kminek22/rc-car/cad/stl/rc car.stl

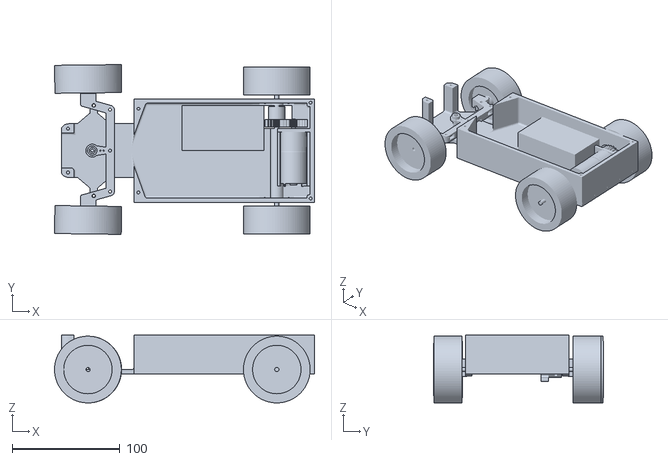
[picture p1: CAD file, 2026-11-02]
cad/stl/rc car.stl
241.5 x 157.8 x 63.0
