kminek22/rc-car/cad/stl/koło.stl

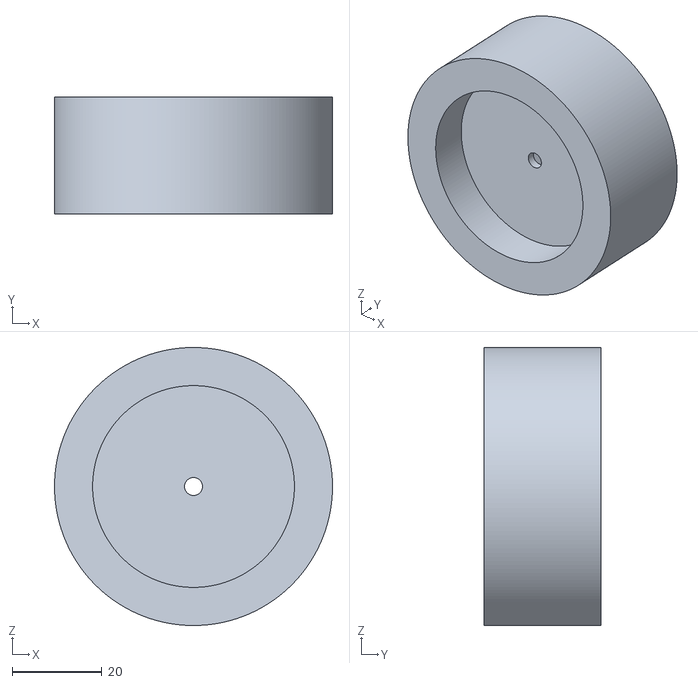
[picture p2: CAD file, 2026-11-02]
cad/stl/koło.stl
62.0 x 26.0 x 62.0
