kminek22/rc-car/cad/stl/zebatka1.stl

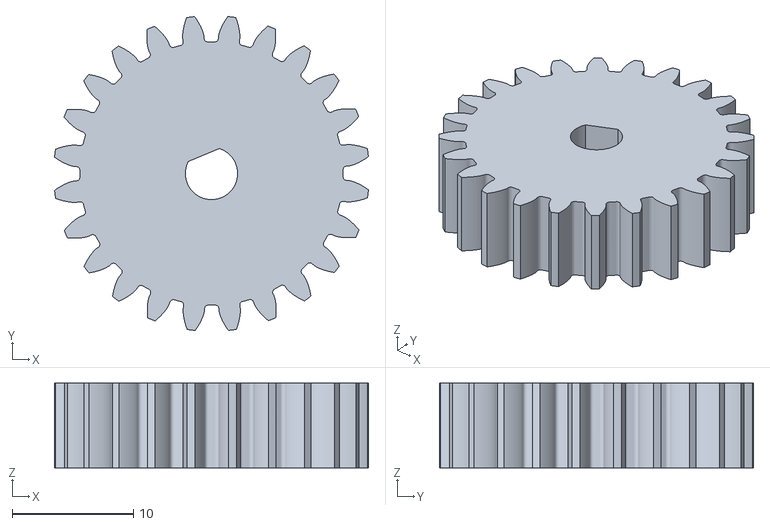
[picture p3: CAD file, 2026-11-02]
cad/stl/zebatka1.stl
25.9 x 25.9 x 7.00
