kminek22/rc-car/cad/stl/adapter.stl

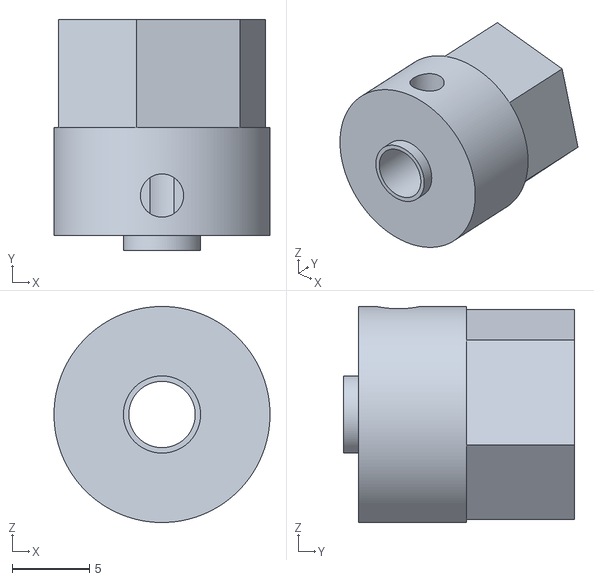
[picture p4: CAD file, 2026-11-02]
cad/stl/adapter.stl
14.0 x 15.0 x 14.0
