kminek22/rc-car/cad/stl/podwozie.stl

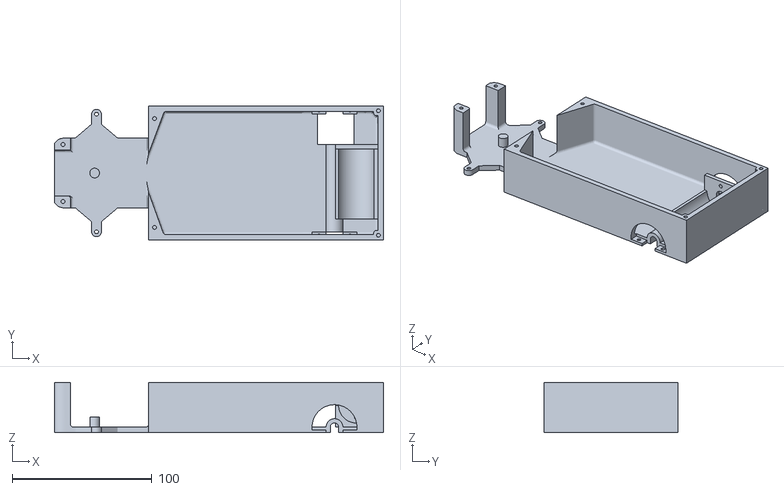
[picture p5: CAD file, 2026-11-02]
cad/stl/podwozie.stl
235.0 x 96.0 x 36.0
