kminek22/rc-car/cad/stl/zacisk.stl

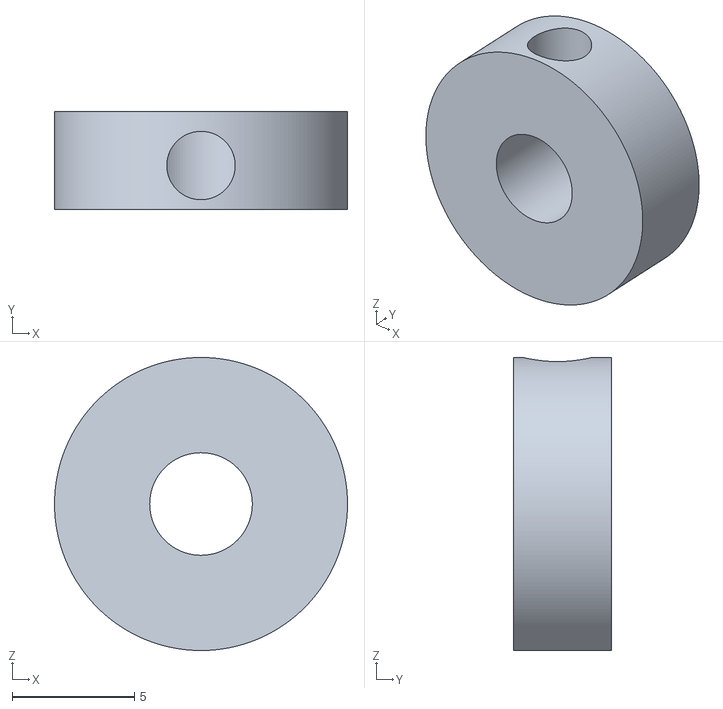
[picture p6: CAD file, 2026-11-02]
cad/stl/zacisk.stl
12.0 x 4.00 x 12.0
