kminek22/rc-car/cad/stl/drazek_acermann.stl

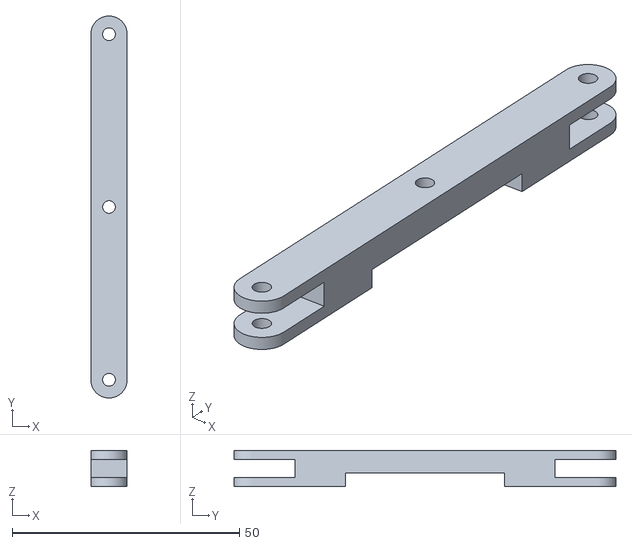
[picture p7: CAD file, 2026-11-02]
cad/stl/drazek_acermann.stl
8.00 x 84.0 x 8.00
