kminek22/rc-car/cad/stl/wałek.stl

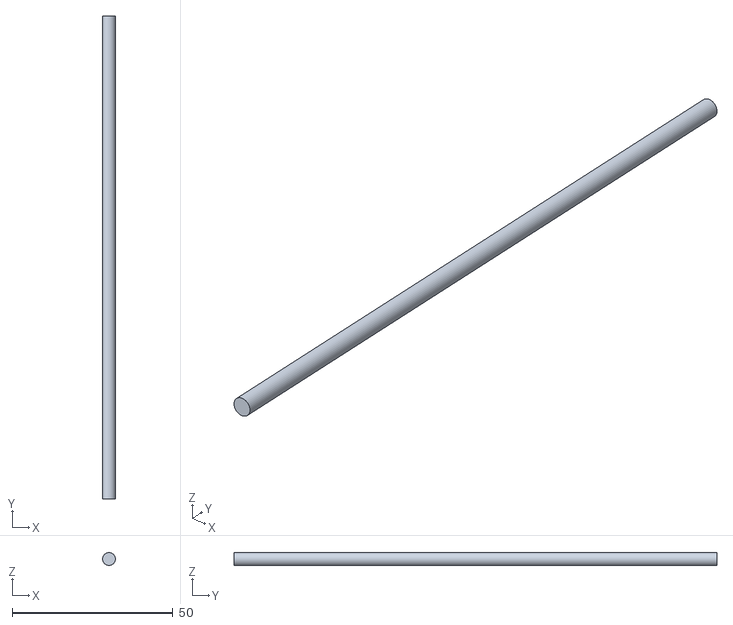
[picture p8: CAD file, 2026-11-02]
cad/stl/wałek.stl
3.99 x 150.0 x 4.00
