kminek22/rc-car/cad/stl/zwrotnicaP.stl

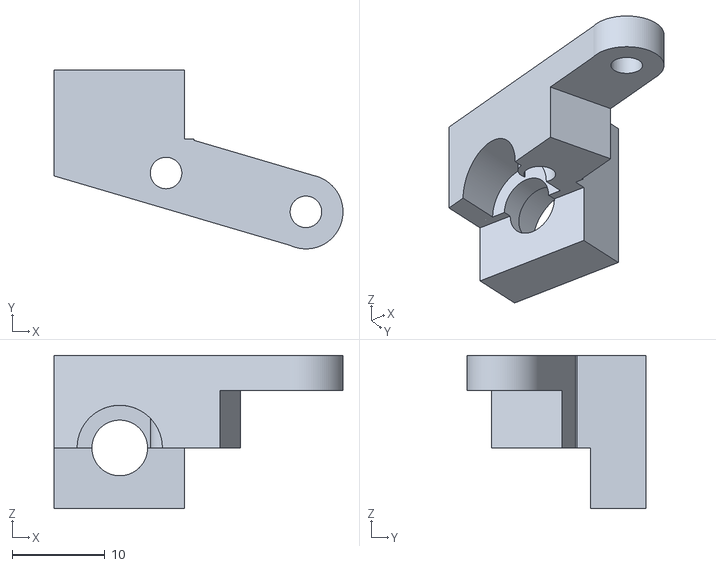
[picture p9: CAD file, 2026-11-02]
cad/stl/zwrotnicaP.stl
31.2 x 19.3 x 16.6
