kminek22/rc-car/cad/stl/zebatka2.stl

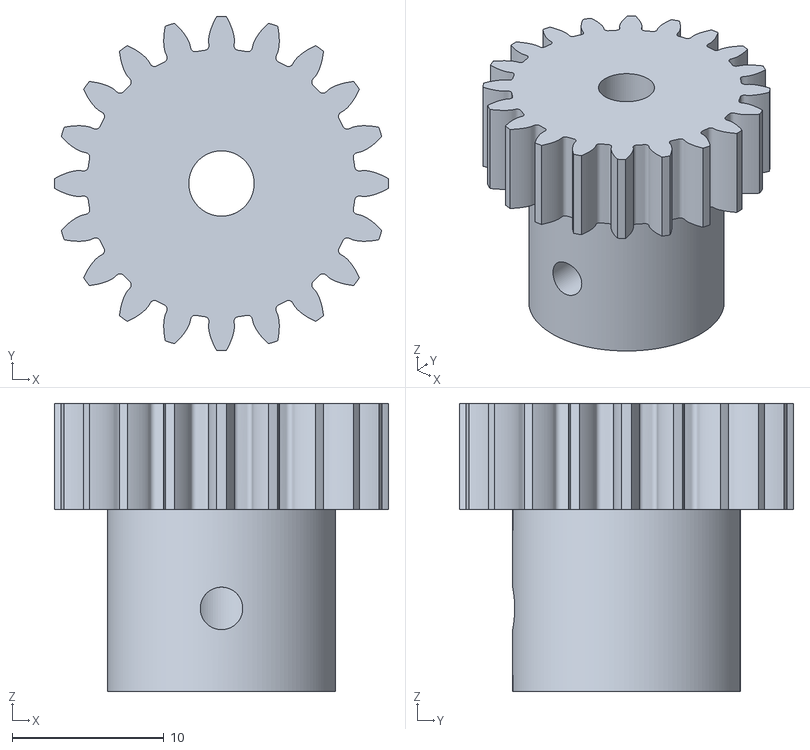
[picture p10: CAD file, 2026-11-02]
cad/stl/zebatka2.stl
22.0 x 22.0 x 19.0
