kminek22/rc-car/cad/stl/holderLOZYSKA.stl

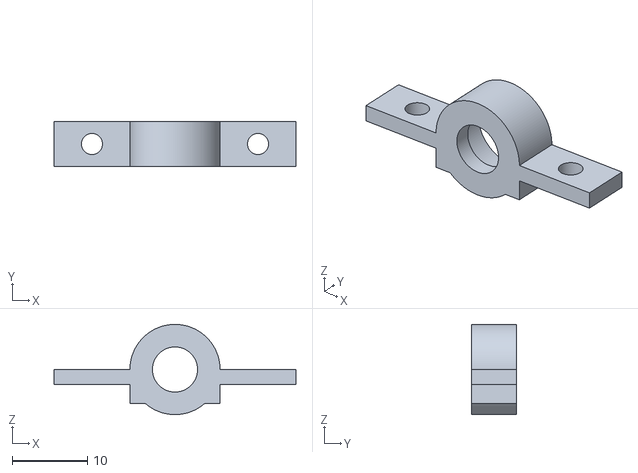
[picture p11: CAD file, 2026-11-02]
cad/stl/holderLOZYSKA.stl
32.2 x 6.00 x 12.0
