kminek22/rc-car/(list of files, cad)

Other CAD files:
cad/stl/zwrotnicaL.stl
cad/f3z/rc car.f3z
