kminek22/rc-car/(commit log)

2026-11-02 Dodane pliki STL autka RC
    [adapter.stl, drazek_acermann.stl, holderLOZYSKA.stl, koło.stl, podwozie.stl, rc car.stl, wałek.stl, zacisk.stl]
2026-11-02 commi 3fz
    [rc car.f3z]
